LenShustek/PoolSpaController/version 3/switchboard_pcb.jpg

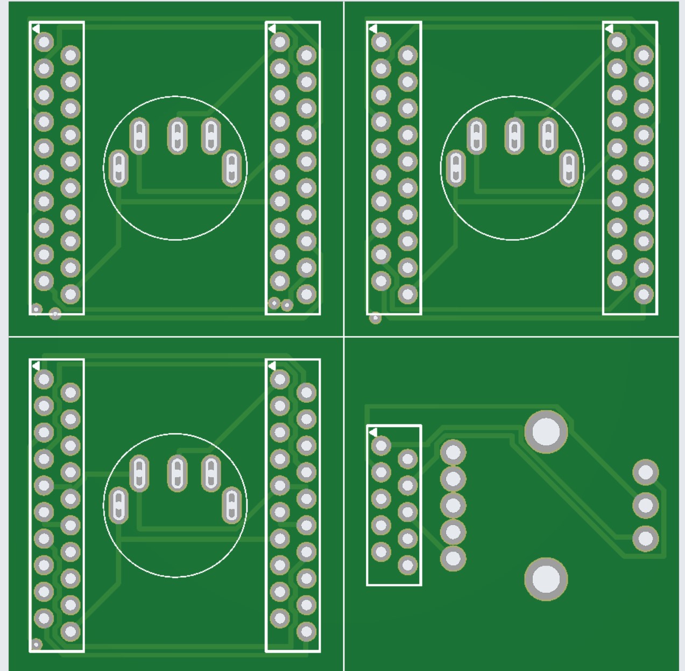
version 3/switchboard_pcb.jpg
