LenShustek/PoolSpaController/version 3/front.jpg

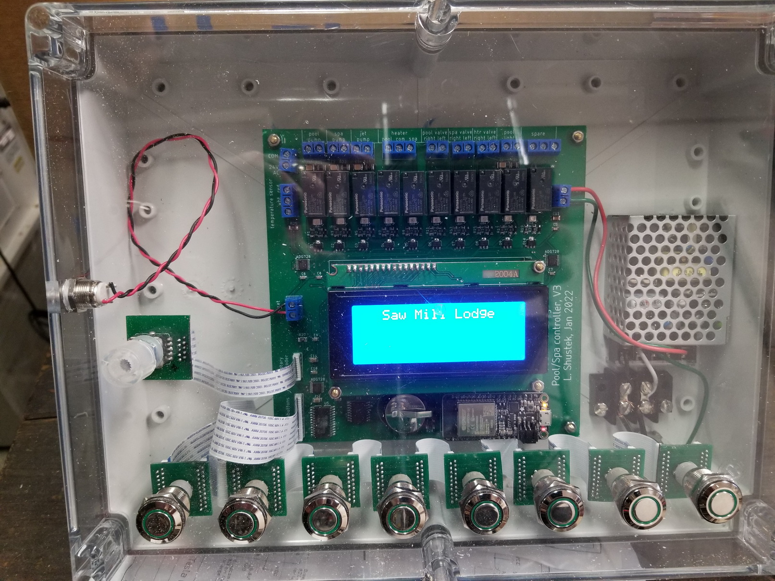
version 3/front.jpg
