LenShustek/PoolSpaController/version 3/pool_controller_3_pcb.pdf

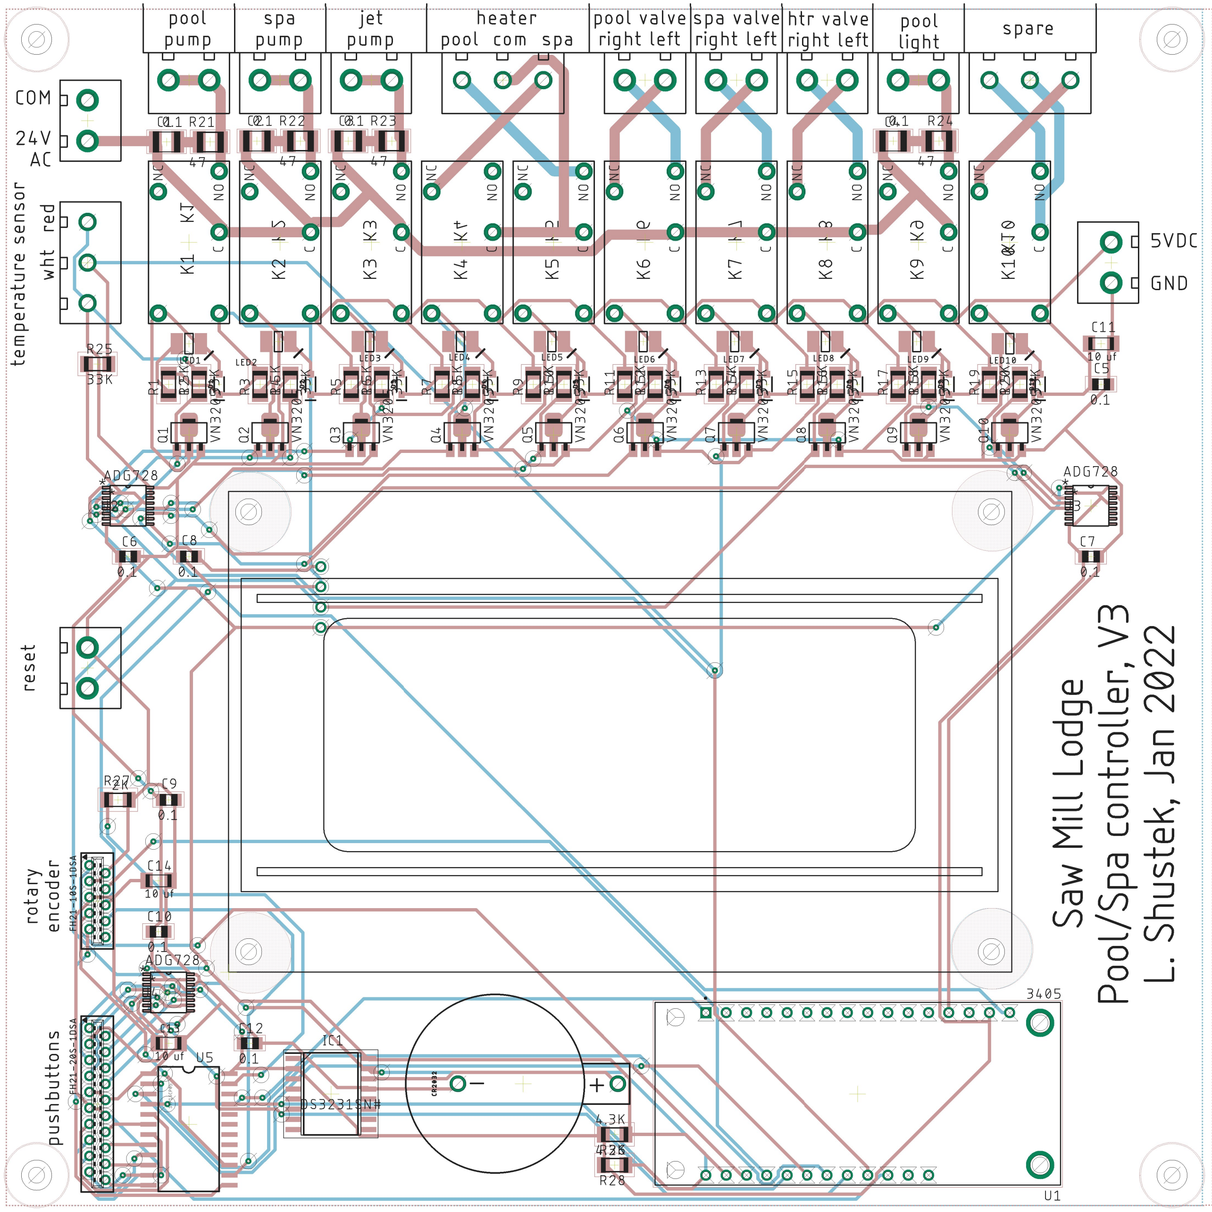
[picture p3: figure]

2/15/2022 3:47 PM f=1.23 C:\data\SawMillLodge\documentation\pool controller\controller_03\controller3.brd
