LenShustek/PoolSpaController/heat_spa.JPG

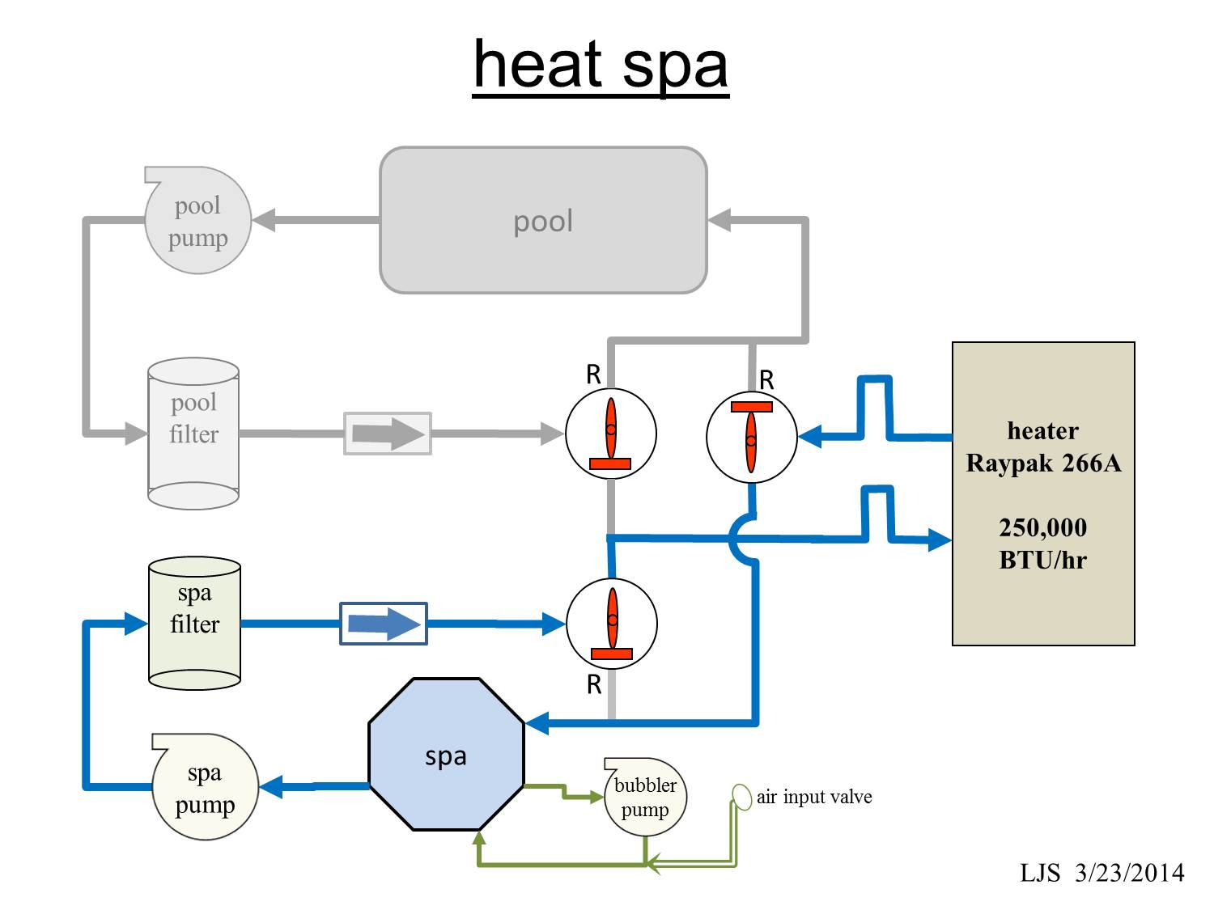
heat_spa.JPG
