LenShustek/PoolSpaController/version 3/pool_controller_3_pcb.jpg

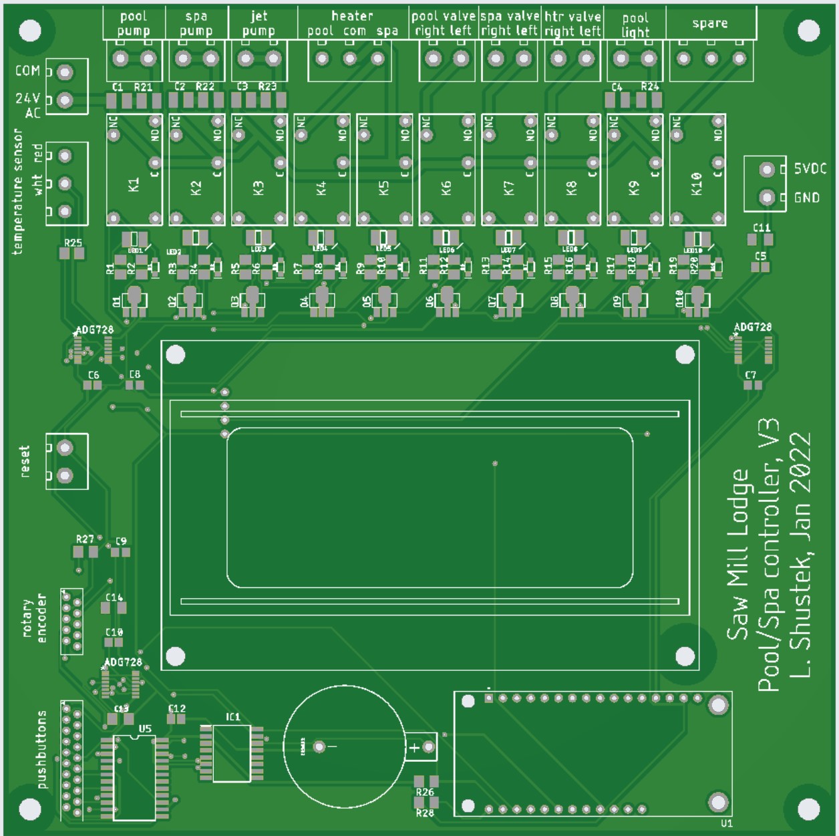
version 3/pool_controller_3_pcb.jpg
