LenShustek/PoolSpaController/version 3/switchboard_FFC_schematic.pdf

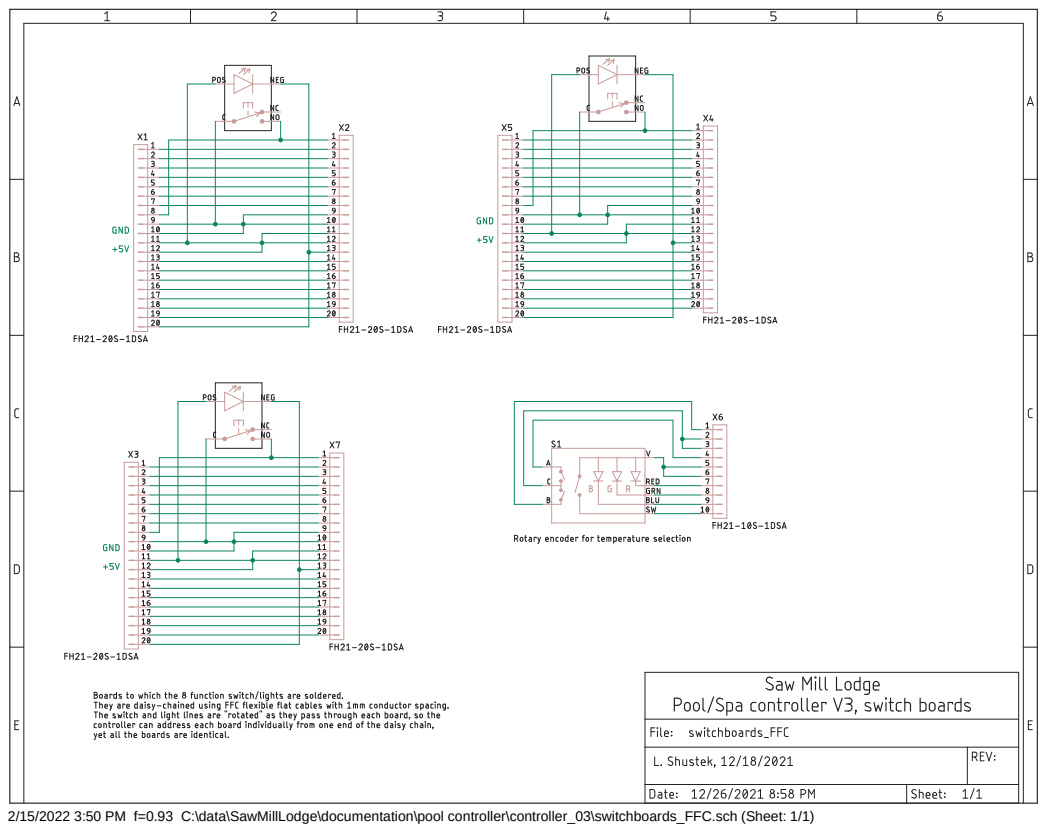
[picture p6: page 1]

2/15/2022 3:50 PM f=0.93 C:\data\SawMillLodge\documentation\pool controller\controller_03\switchboards_FFC.sch (Sheet: 1/1)
