LenShustek/PoolSpaController/version 3/pool_controller_3_schematic.pdf

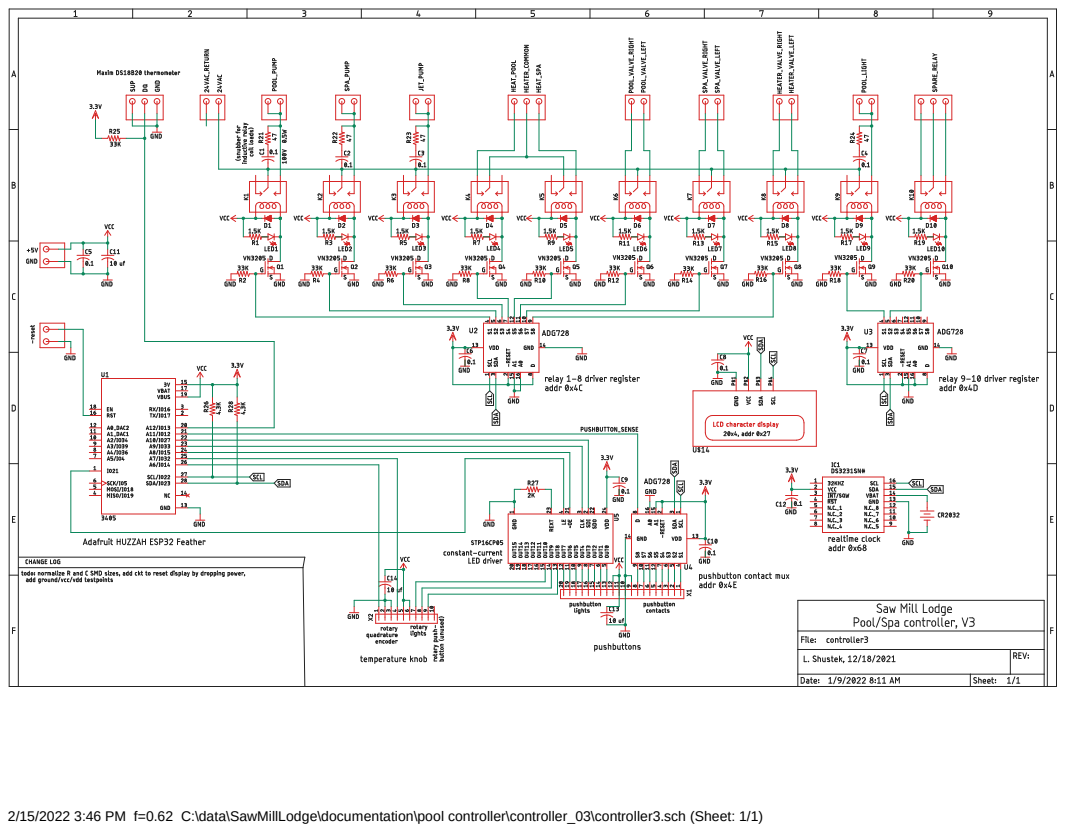
[picture p7: page 1]

2/15/2022 3:46 PM f=0.62 C:\data\SawMillLodge\documentation\pool controller\controller_03\controller3.sch (Sheet: 1/1)
